eightywon/thermi.pro/thermi.kicad_pcb

## KiCad design thermi.kicad_pcb (2020-01-23)

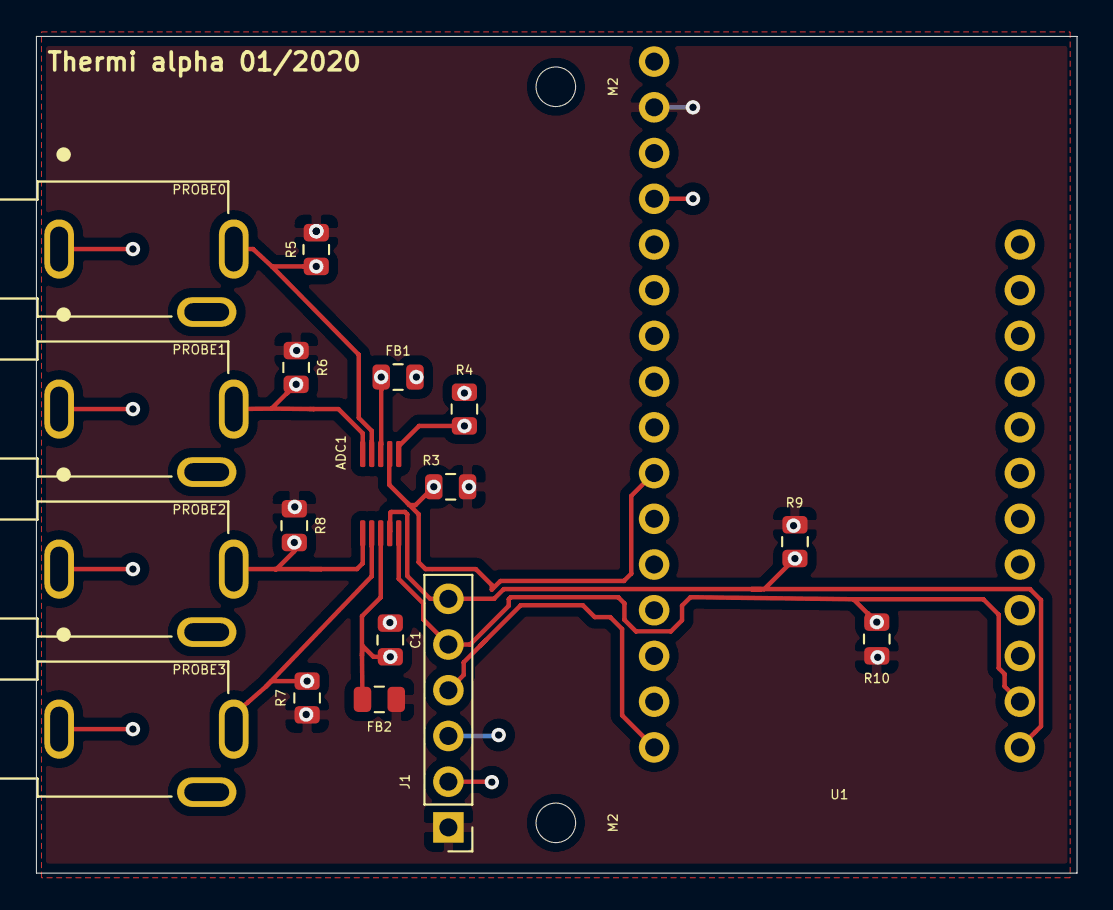
[picture p1: board thermi.kicad_pcb from above]

Board: 2 copper layers, 57.8 x 46.5 mm, 20 parts (0 on the bottom side), 13 nets.

Parts:
ADC1: ADS1115IDGST; VSSOP-10_3x3mm_P0.5mm
C1: 1uf; C_0805_2012Metric
FB1, FB2: MMZ2012Y152B; R_0805_2012Metric
J1: Conn_01x06_Male; PinHeader_1x06_P2.54mm_Vertical
M2, M2#2: MountingHole_2.2mm_M2
PROBE0, PROBE1, PROBE2, PROBE3: MJ-2508; CUI_MJ-2508
R3, R4, R5, R6, R7, R8, R9, R10: 10k; R_0805_2012Metric
U1: ESP32_HUZZAH

Connections:
GND: C1.2, FB1.1, J1.3, PROBE0.1, PROBE1.1, PROBE2.1, PROBE3.1, R4.1, U1.4
unnamed: ADC1.1, R4.2
unnamed: ADC1.2, R3.2, U1.10
unnamed: ADC1.3, FB1.2
unnamed: ADC1.4, PROBE0.2, R5.2
unnamed: ADC1.5, PROBE1.2, R6.2
unnamed: ADC1.6, PROBE2.2, R8.2
unnamed: ADC1.7, PROBE3.2, R7.2
unnamed: ADC1.8, C1.1, FB2.2
unnamed: ADC1.9, J1.6, R9.2, U1.28
unnamed: ADC1.10, J1.5, R10.2, U1.27
unnamed: J1.4, U1.16
VDD: FB2.1, J1.1, R3.1, R5.1, R6.1, R7.1, R8.1, R9.1, R10.1, U1.2
